kfeger/ManniRaspiRadio/README.md

# ManniRaspiRadio
Das Geburtstagsgeschenk zum 60ten von manni.42
Es wird einem alten DDR-Röhren-Radio neues Leben eingehaucht. Alles wird durch einen Arduino Nano (der Schnick-Schnack) und einen RasPi (Media-Player a la KODI).
Für alles weitere: Lesen...
