kfeger/ManniRaspiRadio/Neues Script für ManniRaspiRadio-ohne Bild.docx

Neues Script für ManniRaspiRadio

Shutdown des Pi wird über /storage/shutdownPi.py realisiert. Dieses Script wird durch die Datei autostart.sh im Ordner /storage/.config aufgerufen und im Hintergrund (&) ausgeführt. Die Datei autostart.sh wird bei Start des Systems automatisch ausgeführt. Siehe

https://wiki.libreelec.tv/configuration/startup-shutdown

Shutdown von Nano wird eingeleitet durch Low-Signal an Pin GPIO 19

Die Rückmeldung an Nano erfolgt durch HighZ von Pin GPIO 26

Pinout:

https://pinout.xyz/#
