kfeger/ManniRaspiRadio/ManniRaspiRadioBlock.sch.pdf

# ManniRaspiRadio

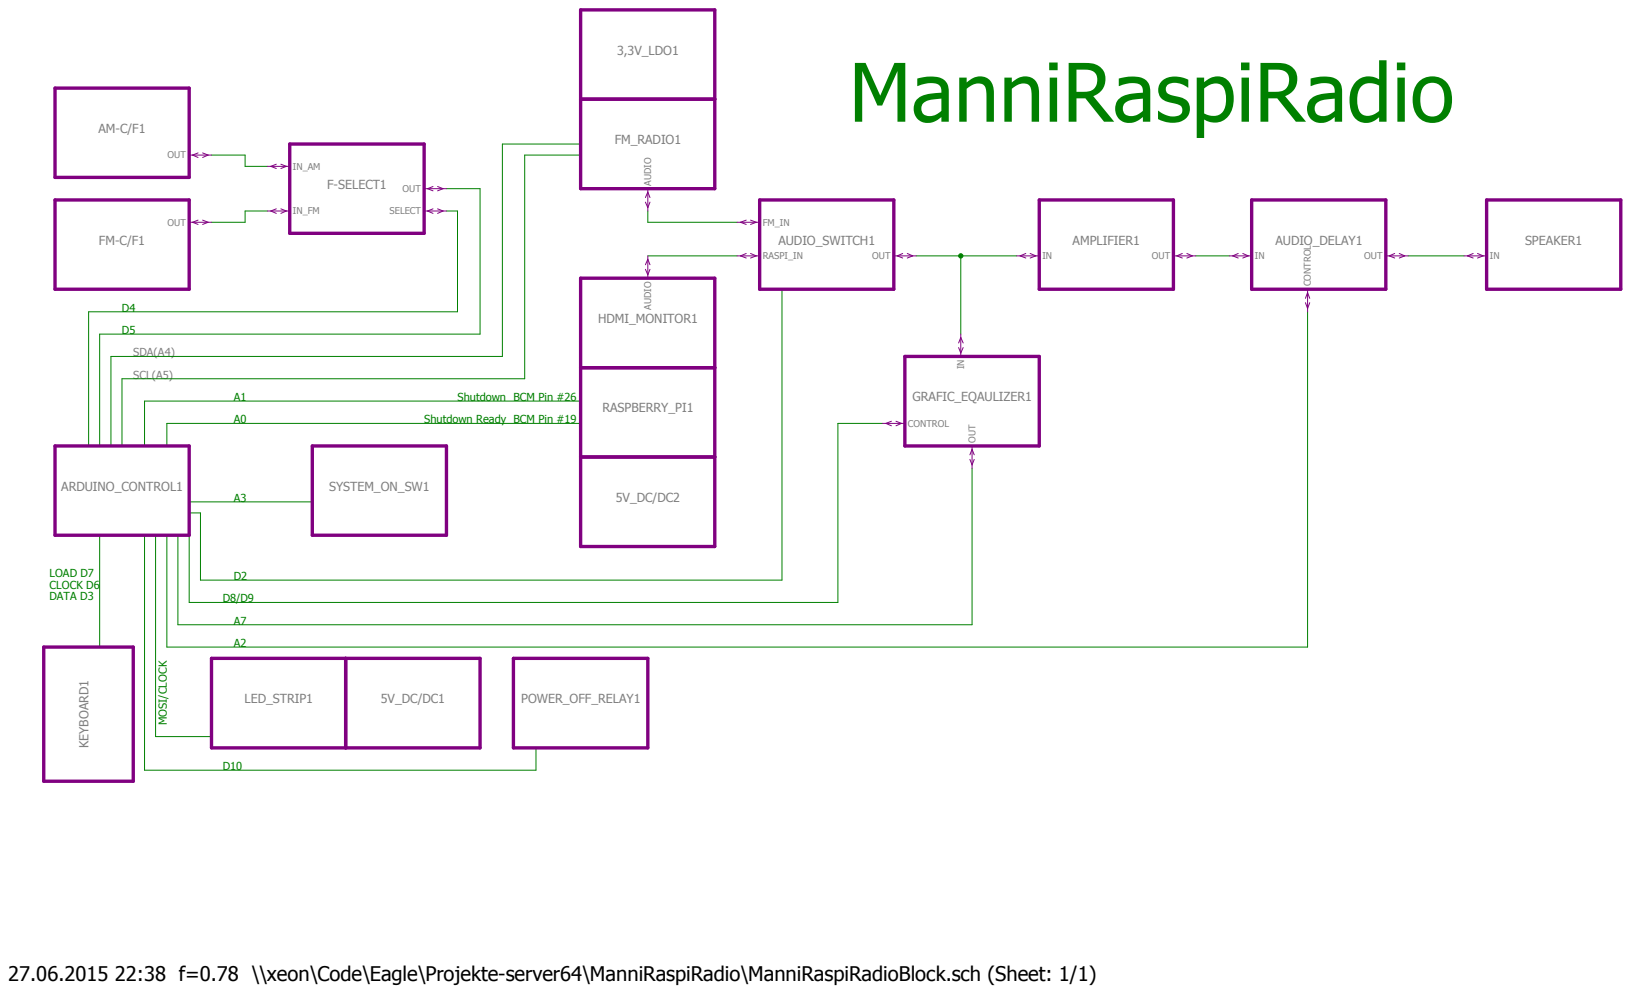
[picture p1: page 1]
OUT; F-SELECT1; SELECT; GRAFIC_EQAULIZER1; OUTCONTROL; AUDIO_SWITCH1; RASPI_IN; AMPLIFIER1; RASPBERRY_PI1; FM_RADIO1; AUDIO; KEYBOARD1 LED_STRIP1 5V_DC/DC1; HDMI_MONITOR1; 3,3V_LDO1; AUDIO_DELAY1; CONTROL; SPEAKER1; ARDUINO_CONTROL1; POWER_OFF_RELAY1; SYSTEM_ON_SW1; SDA(A4); SCL(A5); Shutdown; LOAD D7 CLOCK D6 DATA D3; MOSI/CLOCK; BCM Pin #26

Shutdown Ready BCM Pin #19

27.06.2015 22:38 f=0.78 \\xeon\Code\Eagle\Projekte-server64\ManniRaspiRadio\ManniRaspiRadioBlock.sch (Sheet: 1/1)
