kfeger/ManniRaspiRadio/ManniRaspiRadio.sch.pdf

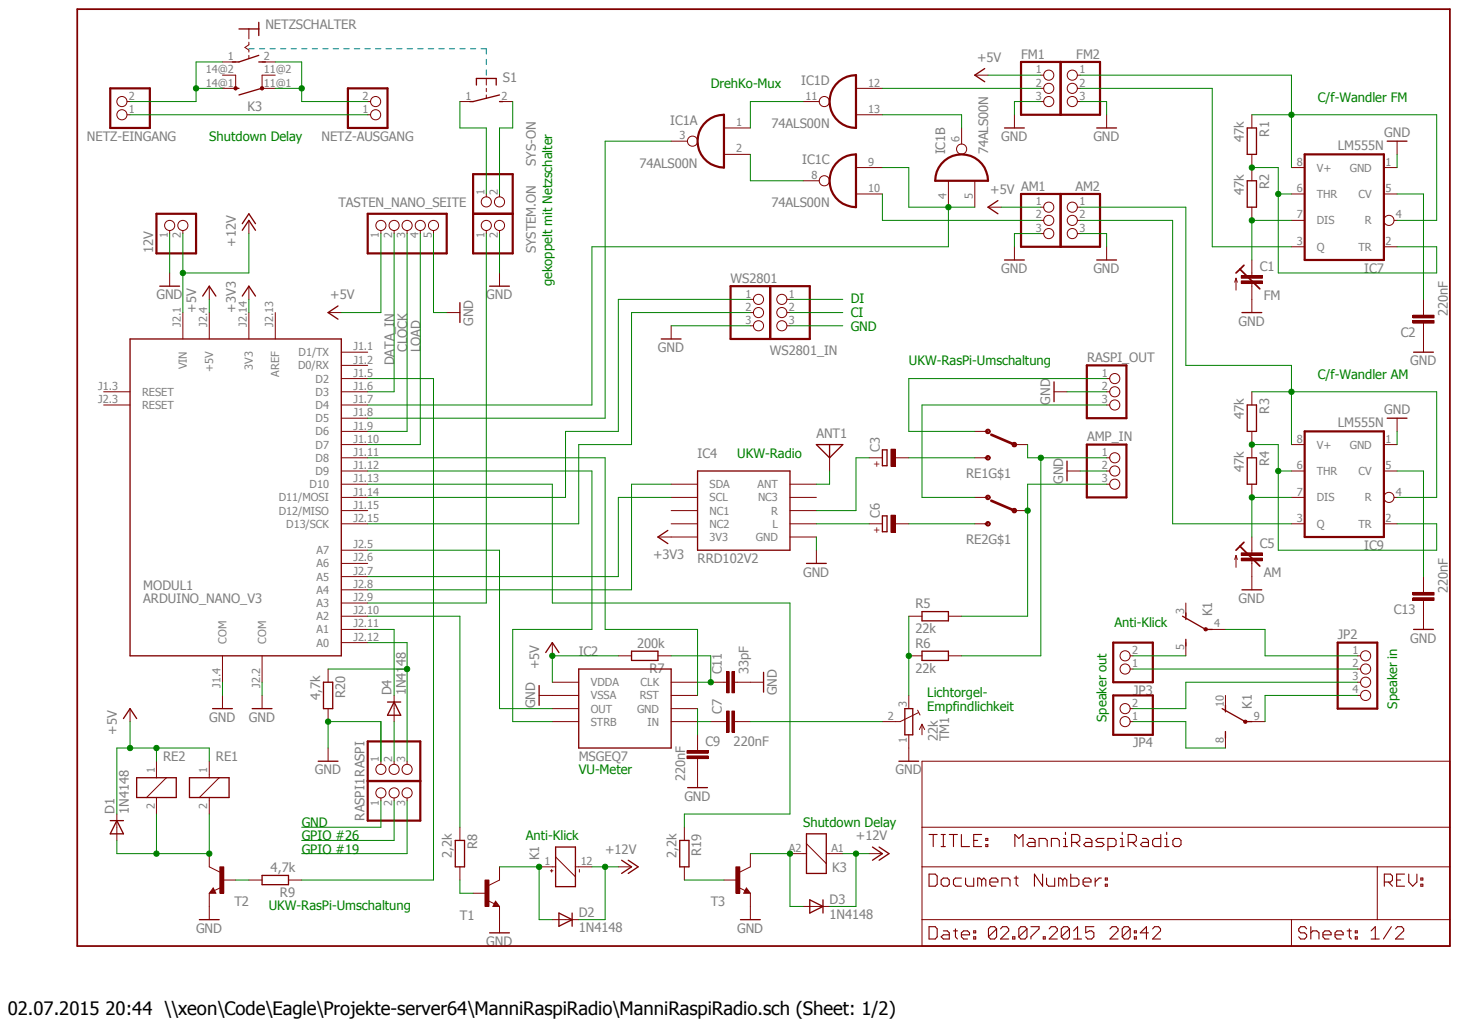
[picture p2: page 1]

02.07.2015 20:44 \\xeon\Code\Eagle\Projekte-server64\ManniRaspiRadio\ManniRaspiRadio.sch (Sheet: 1/2)

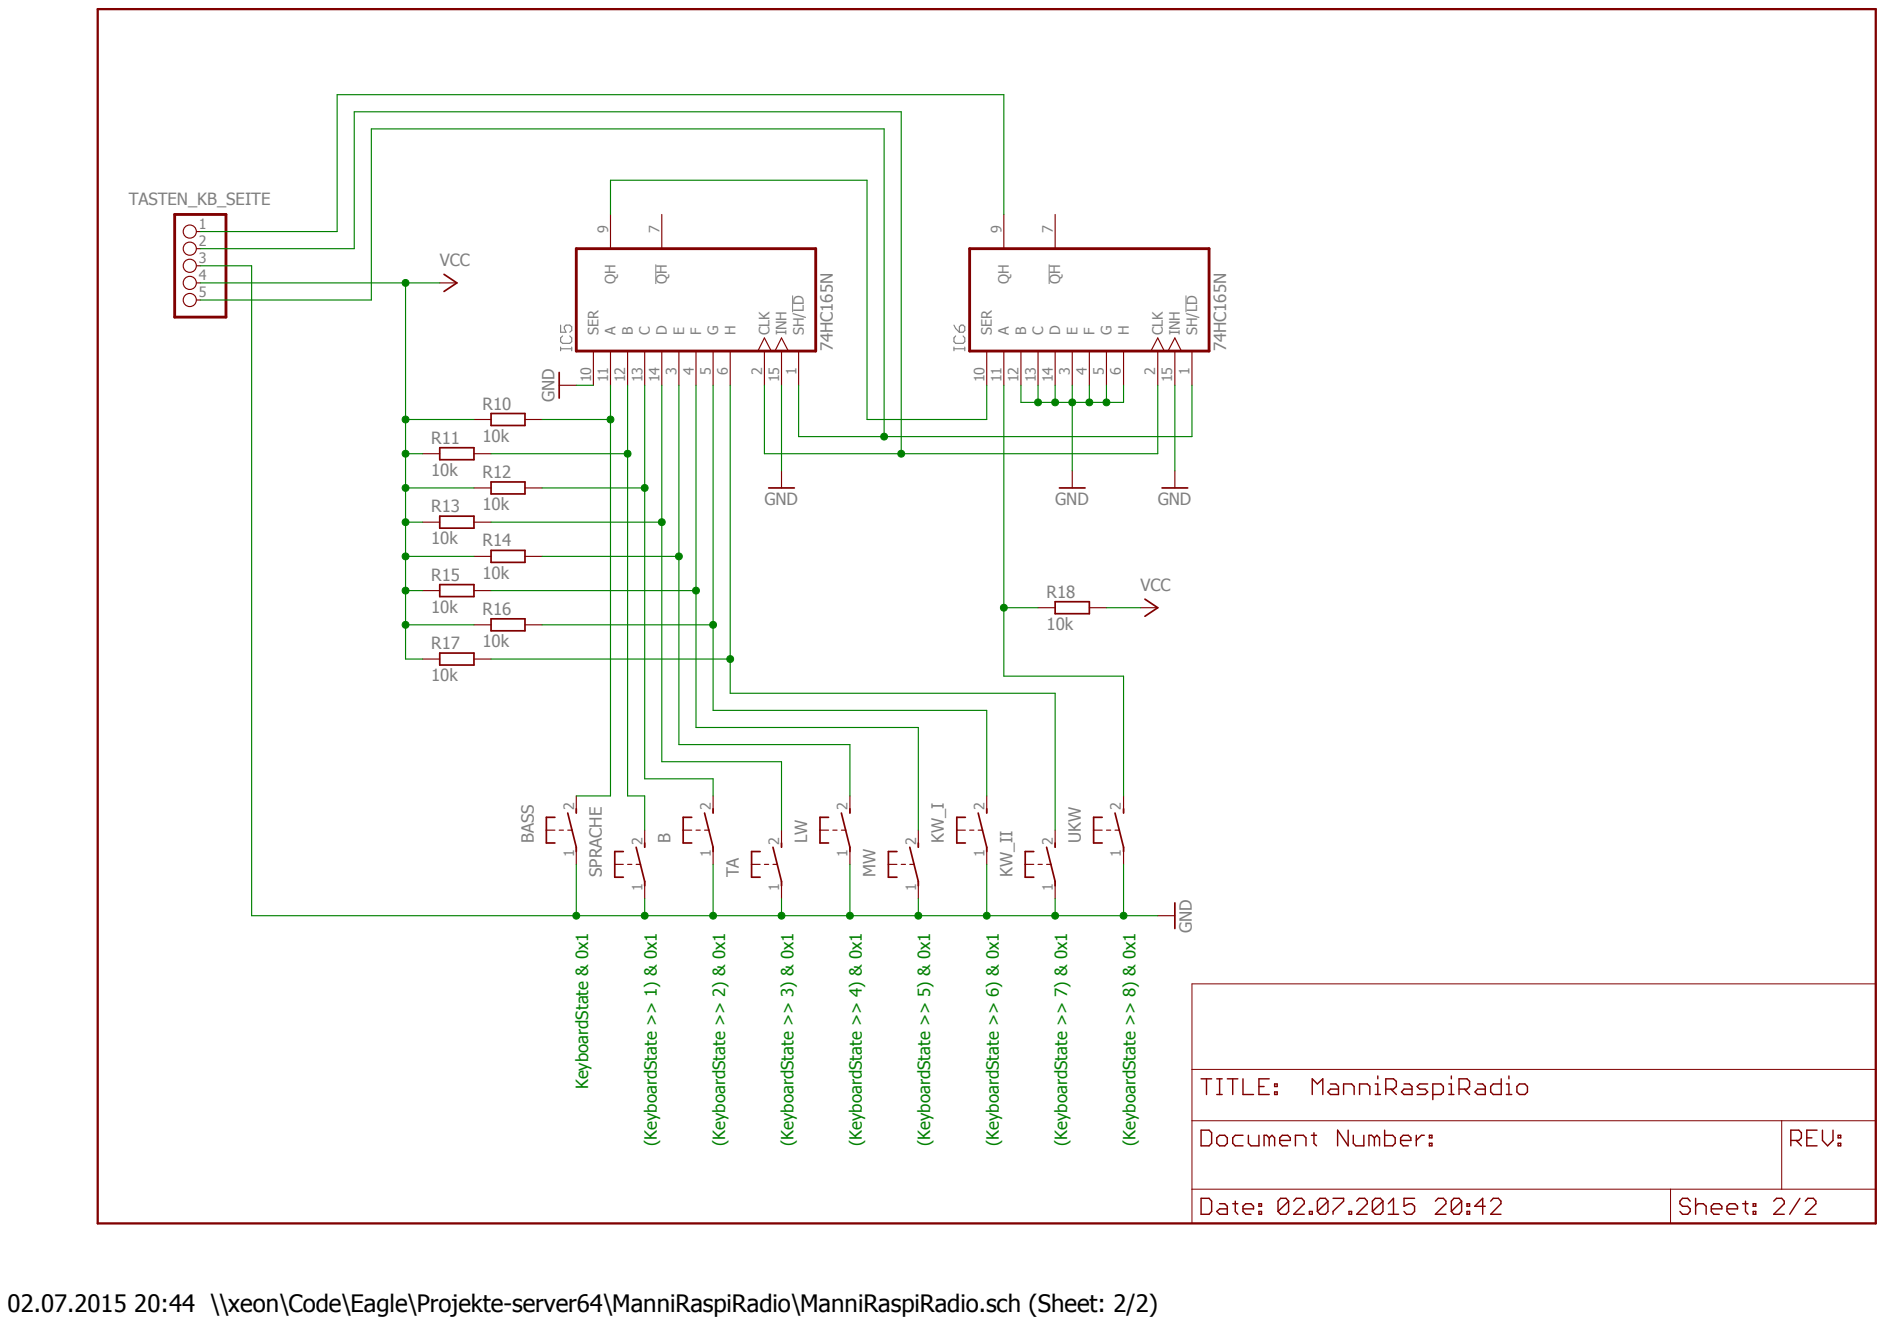
[picture p3: page 2]

02.07.2015 20:44 \\xeon\Code\Eagle\Projekte-server64\ManniRaspiRadio\ManniRaspiRadio.sch (Sheet: 2/2)
