kfeger/ManniRaspiRadio/ManniRaspiRadio.sch

## EAGLE design ManniRaspiRadio.sch (2019-11-09)

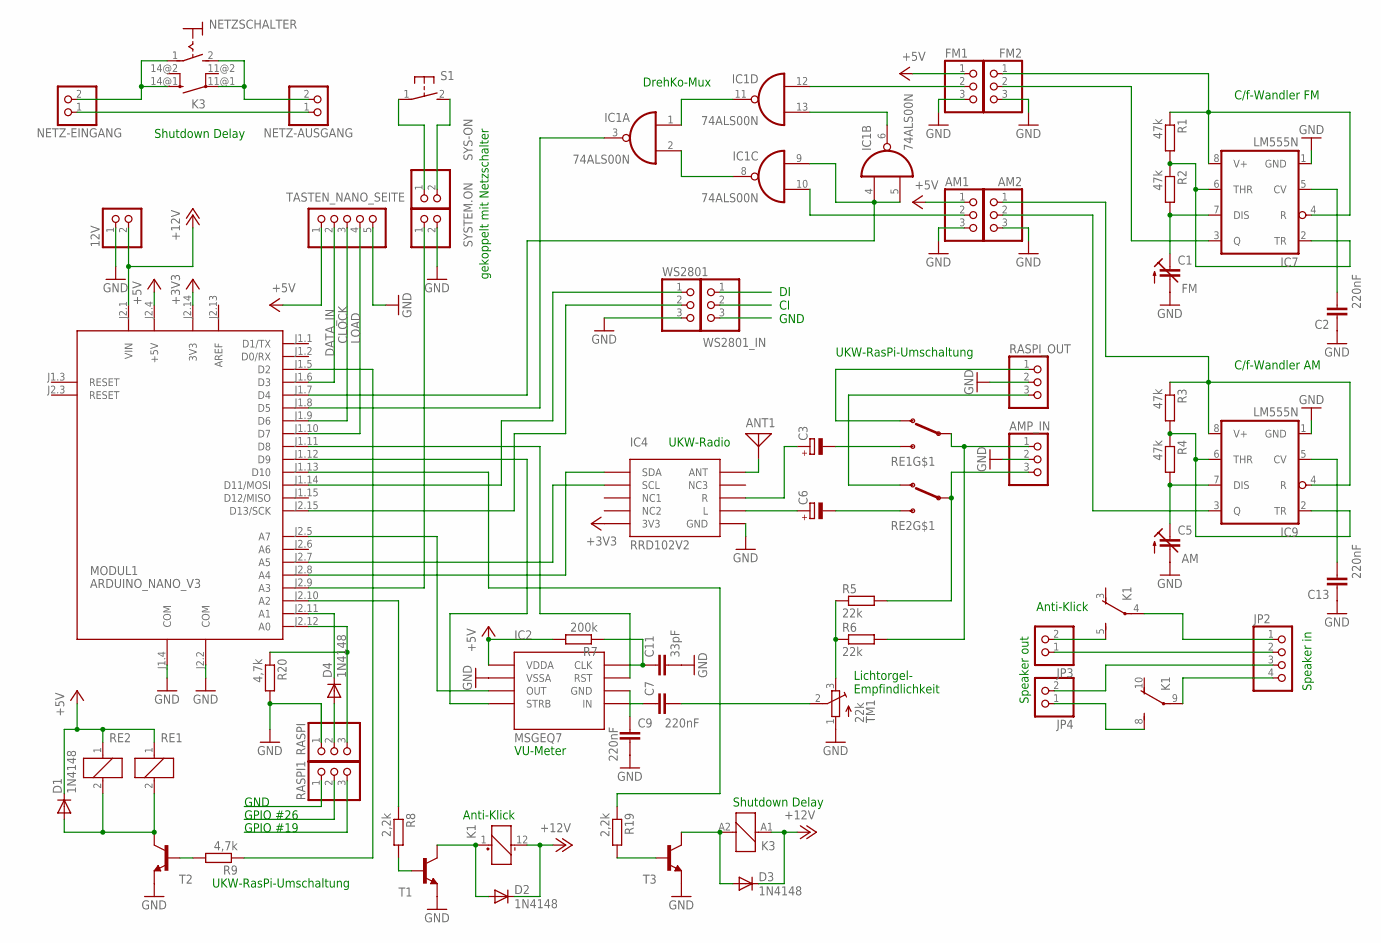
[picture p4: schematic ManniRaspiRadio.sch, sheet 1]

Parts:
12V: PINHD-1X2; 1X02
AM1, AM2: PINHD-1X3; 1X03
AMP_IN: PINHD-1X3; 1X03
ANT1: ANTENNA; PAD-01
C1: FM; CTRIM3018_12
C2, C7, C9, C13: 220nF; C025-030X050
C3, C6: CPOL-EU139CLL-2W; 139CLL-2W
C5: AM; CTRIM3018_12
C11: 33pF; C025-030X050
D1, D2, D3, D4: 1N4148; DO35-10
FM1, FM2: PINHD-1X3; 1X03
IC1: 74ALS00N; DIL14
IC2: MSGEQ7
IC4: RRD102V2
IC7, IC9: LM555N; DIL08
JP2: PINHD-1X4; 1X04
JP3, JP4: PINHD-1X2; 1X02
K1: TXD2-12V; TXD2
K3: FINDER-43.61
MODUL1: ARDUINO_NANO_V3; ARDUINO_NANO2
NETZ-AUSGANG: PINHD-1X2; 1X02
NETZ-EINGANG: PINHD-1X2; 1X02
NETZSCHALTER: MS243
R1, R2, R3, R4: 47k; 0207/10
R5, R6: 22k; 0207/10
R7: 200k; 0207/10
R8, R19: 2,2k; 0207/10
R9, R20: 4,7k; 0207/10
RASPI, RASPI1: PINHD-1X3; 1X03
RASPI_OUT: PINHD-1X3; 1X03
RE1, RE2: RE-SPDT--G5LE; EPP-RELAY-G5LE
S1: 31-XX; B3F-31XX
SYS-ON: PINHD-1X2; 1X02
SYSTEM.ON: PINHD-1X2; 1X02
T1, T2, T3: T-NPN-BC337-; EPP-TO-92
TASTEN_NANO_SEITE: PINHD-1X5; 1X05
TM1: 22k; TRIM-3386
WS2801, WS2801_IN: PINHD-1X3; 1X03

Connections:
+3V3: IC4.P$5 (3V3), MODUL1.J2.14 (3V3)
+5V: AM1.1, D1.C, FM1.1, IC2.P$1 (VDDA), MODUL1.J2.4 (+5V), R7.2, RE1.1, RE2.1, TASTEN_NANO_SEITE.1
+12V: 12V.2, D2.C, D3.C, K1.12 (-), K3.A1 (1), MODUL1.J2.1 (VIN)
CLOCK: MODUL1.J1.9 (D6), TASTEN_NANO_SEITE.3
DATA_IN: MODUL1.J1.6 (D3), TASTEN_NANO_SEITE.2
GND: 12V.1, AM1.3, AM2.3, AMP_IN.2, C1.- (A), C2.1, C5.- (A), C9.2, C11.2, C13.1, FM1.3, FM2.3, IC2.P$2 (VSSA), IC4.P$6 (GND), IC7.1 (GND), IC9.1 (GND), MODUL1.J1.4 (COM), MODUL1.J2.2 (COM), R20.2, RASPI.1, RASPI_OUT.2, SYSTEM.ON.2, T1.3 (E), T2.3 (E), T3.3 (E), TASTEN_NANO_SEITE.5, TM1.1 (A), WS2801.3
LOAD: MODUL1.J1.10 (D7), TASTEN_NANO_SEITE.4
unnamed: C3.+, IC4.P$8 (R)
unnamed: C6.+, IC4.P$7 (L)
unnamed: IC4.P$1 (SDA), MODUL1.J2.8 (A4)
unnamed: D1.A, RE1.2, RE2.2, T2.1 (C)
unnamed: IC4.P$2 (SCL), MODUL1.J2.7 (A5)
unnamed: ANT1.1, IC4.P$10 (ANT)
unnamed: JP3.2, K1.5 (S)
unnamed: AMP_IN.1, R6.2, RE1.P
unnamed: AMP_IN.3, R5.2, RE2.P
unnamed: RASPI_OUT.3, RE2.O
unnamed: RASPI_OUT.1, RE1.O
unnamed: C1.+ (E), IC7.7 (DIS), R2.2
unnamed: IC7.2 (TR), IC7.6 (THR), R1.2, R2.1
unnamed: AM2.1, IC9.4 (R), IC9.8 (V+), R3.1
unnamed: FM2.1, IC7.4 (R), IC7.8 (V+), R1.1
unnamed: FM2.2, IC7.3 (Q)
unnamed: C2.2, IC7.5 (CV)
unnamed: AM2.2, IC9.3 (Q)
unnamed: C5.+ (E), IC9.7 (DIS), R4.2
unnamed: IC9.2 (TR), IC9.6 (THR), R3.2, R4.1
unnamed: R5.1, R6.1, TM1.3 (E)
unnamed: IC1.1 (I0), IC1.11 (O)
unnamed: C3.-, RE1.S
unnamed: C6.-, RE2.S
unnamed: IC1.2 (I1), IC1.8 (O)
unnamed: IC1.6 (O), IC1.13 (I1)
unnamed: IC1.4 (I0), IC1.5 (I1), IC1.9 (I0), MODUL1.J1.7 (D4)
unnamed: C13.2, IC9.5 (CV)
unnamed: R8.2, T1.2 (B)
unnamed: IC1.3 (O), MODUL1.J1.8 (D5)
unnamed: IC2.P$3 (OUT), MODUL1.J2.5 (A7)
unnamed: IC2.P$4 (STRB), MODUL1.J1.12 (D9)
unnamed: C7.2, TM1.2 (S)
unnamed: C9.1, IC2.P$6 (GND)
unnamed: MODUL1.J2.10 (A2), R8.1
unnamed: C7.1, IC2.P$5 (IN)
unnamed: D2.A, K1.1 (+), T1.1 (C)
unnamed: C11.1, IC2.P$8 (CLK), R7.1
unnamed: IC2.P$7 (RST), MODUL1.J1.11 (D8)
unnamed: MODUL1.J1.14 (D11/MOSI), WS2801.1
unnamed: MODUL1.J2.15 (D13/SCK), WS2801.2
unnamed: AM1.2, IC1.10 (I1)
unnamed: FM1.2, IC1.12 (I0)
unnamed: JP4.1, K1.8 (S)
unnamed: JP2.1, K1.4
unnamed: R9.2, T2.2 (B)
unnamed: MODUL1.J1.5 (D2), R9.1
unnamed: JP2.2, JP3.1
unnamed: JP2.3, JP4.2
unnamed: JP2.4, K1.9
unnamed: R19.2, T3.2 (B)
unnamed: D3.A, K3.A2 (2), T3.1 (C)
unnamed: MODUL1.J1.13 (D10), R19.1
unnamed: K3.14@1 (SA), NETZ-EINGANG.2, NETZSCHALTER.1
unnamed: K3.11@1 (PA), NETZ-AUSGANG.2, NETZSCHALTER.2 (S)
unnamed: NETZ-AUSGANG.1, NETZ-EINGANG.1
unnamed: D4.C, MODUL1.J2.11 (A1)
unnamed: D4.A, RASPI.2
unnamed: MODUL1.J2.12 (A0), R20.1, RASPI.3
unnamed: MODUL1.J2.9 (A3), SYSTEM.ON.1
unnamed: S1.1, SYS-ON.1
unnamed: S1.2 (S), SYS-ON.2

Notes on the sheet:
DrehKo-Mux
UKW-Radio
UKW-RasPi-Umschaltung
C/f-Wandler AM
C/f-Wandler FM
VU-Meter
Speaker in
Speaker out
Anti-Klick
Shutdown Delay
gekoppelt mit Netzschalter
GND
GPIO #26
GPIO #19
DI CI GND
Lichtorgel- Empfindlichkeit

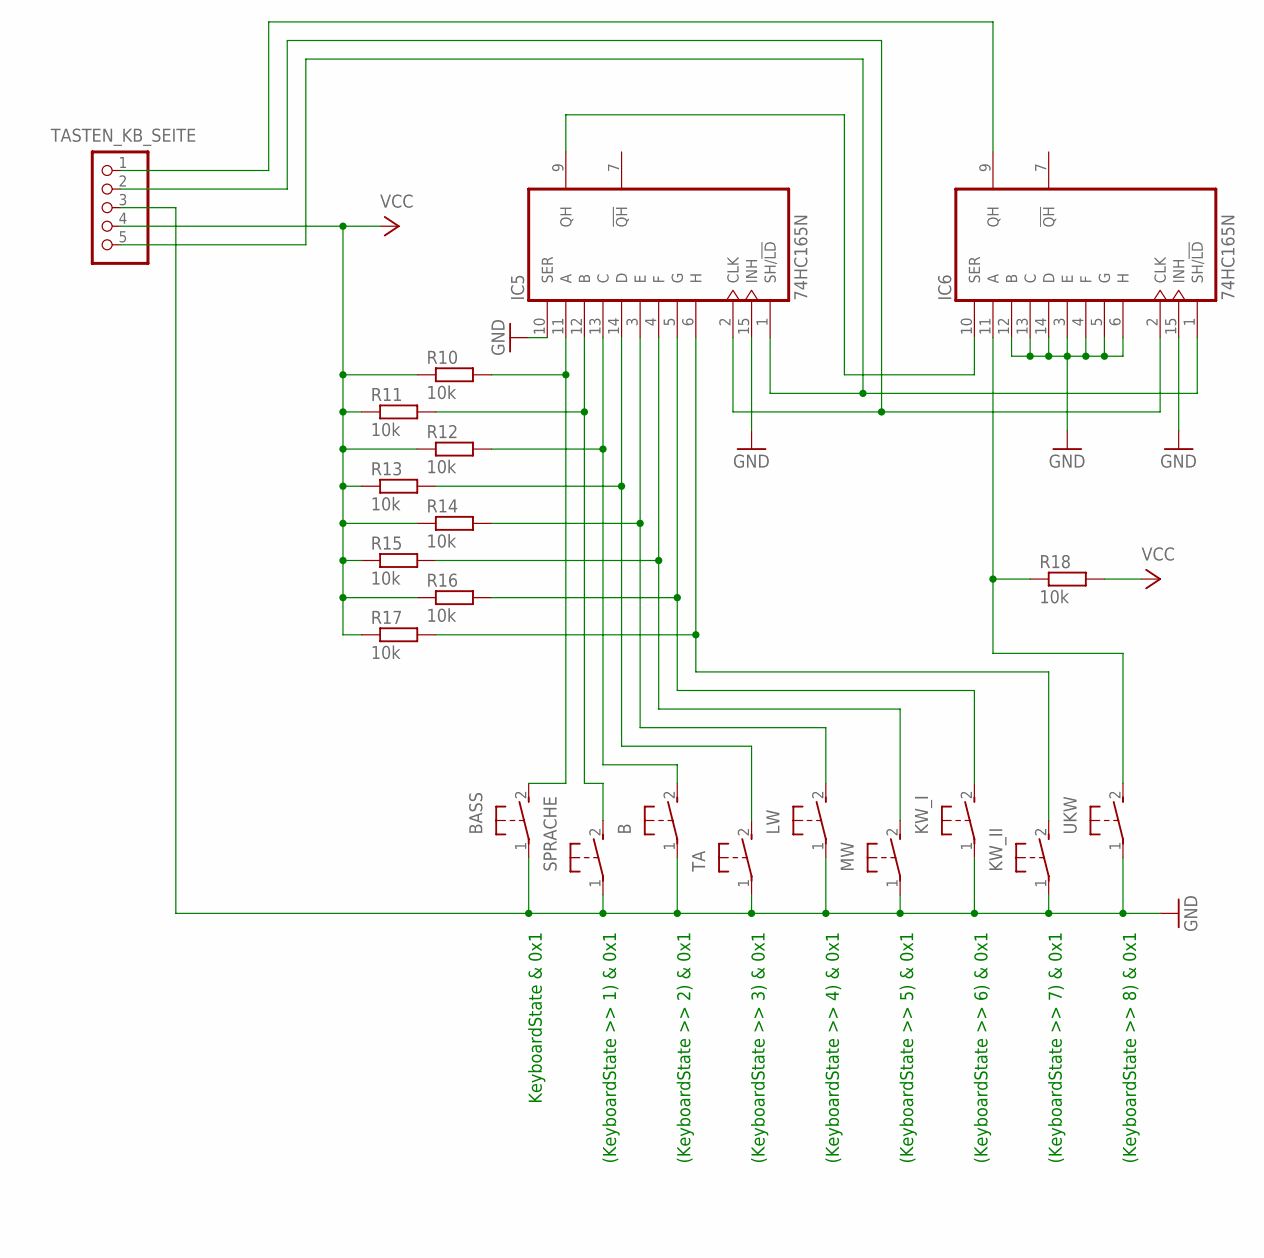
[picture p5: schematic ManniRaspiRadio.sch, sheet 2]

Parts:
B: 31-XX; B3F-31XX
BASS: 31-XX; B3F-31XX
IC5, IC6: 74HC165N; DIL16
KW_I: 31-XX; B3F-31XX
KW_II: 31-XX; B3F-31XX
LW: 31-XX; B3F-31XX
MW: 31-XX; B3F-31XX
R10, R11, R12, R13, R14, R15, R16, R17, R18: 10k; 0207/10
SPRACHE: 31-XX; B3F-31XX
TA: 31-XX; B3F-31XX
TASTEN_KB_SEITE: PINHD-1X5; 1X05
UKW: 31-XX; B3F-31XX

Connections:
GND: B.1, BASS.1, IC5.10 (SER), IC5.15 (INH), IC6.3 (E), IC6.4 (F), IC6.5 (G), IC6.6 (H), IC6.12 (B), IC6.13 (C), IC6.14 (D), IC6.15 (INH), KW_I.1, KW_II.1, LW.1, MW.1, SPRACHE.1, TA.1, TASTEN_KB_SEITE.3, UKW.1
unnamed: BASS.2 (S), IC5.11 (A), R10.2
unnamed: IC5.12 (B), R11.2, SPRACHE.2 (S)
unnamed: B.2 (S), IC5.13 (C), R12.2
unnamed: IC5.14 (D), R13.2, TA.2 (S)
unnamed: IC5.3 (E), LW.2 (S), R14.2
unnamed: IC5.4 (F), MW.2 (S), R15.2
unnamed: IC5.5 (G), KW_I.2 (S), R16.2
unnamed: IC5.6 (H), KW_II.2 (S), R17.2
unnamed: IC6.11 (A), R18.1, UKW.2 (S)
unnamed: IC5.9 (QH), IC6.10 (SER)
unnamed: IC5.2 (CLK), IC6.2 (CLK), TASTEN_KB_SEITE.2
unnamed: IC5.1 (SH/!LD), IC6.1 (SH/!LD), TASTEN_KB_SEITE.5
unnamed: IC6.9 (QH), TASTEN_KB_SEITE.1
VCC: R10.1, R11.1, R12.1, R13.1, R14.1, R15.1, R16.1, R17.1, R18.2, TASTEN_KB_SEITE.4

Notes on the sheet:
KeyboardState & 0x1
(KeyboardState >> 2) & 0x1
(KeyboardState >> 1) & 0x1
(KeyboardState >> 3) & 0x1
(KeyboardState >> 4) & 0x1
(KeyboardState >> 5) & 0x1
(KeyboardState >> 6) & 0x1
(KeyboardState >> 7) & 0x1
(KeyboardState >> 8) & 0x1
